xabirizar9/Micromaus-Challenge-TUM/MM_report.docx

Deadline: Montag 18.04

ToDo: Email an Lenz (X)

1. Introduction, Objectives N(2)
2. Conceptional Design (eagle) N(1)
3. Hardware
  a. Current supply A (1)
  b. Communication (USB API, WIFI) W(1)
  c. Sensing (IR & acceleration?) N (1)
  d. Motor (H-bridge, Encoder) X(1)
  e. ESP32 A(0.5)
4. Software
  a. RTOS (timer, task scheduling etc., class diagram) N (1)
  b. Filtering A(2)
  c. Maze solving (pathfinding) W(1)
  d. Kinematics (Curves, motion profile) X(2)
  e. Controlling (Lane & Motor)
    i. Motor controller N(1)
    ii. lane control X(1)
    iii. auto tuner X(1)
  f. Dashboard + communication W(2)
5. Results and Discussion
  a. results (1)
  b. further improvements (1)

Pages: W:5, A:3.5, X:5, N:6 total: 19.5
