xabirizar9/Micromaus-Challenge-TUM/docs/Micromaus-WS21_22.drawio-2.png

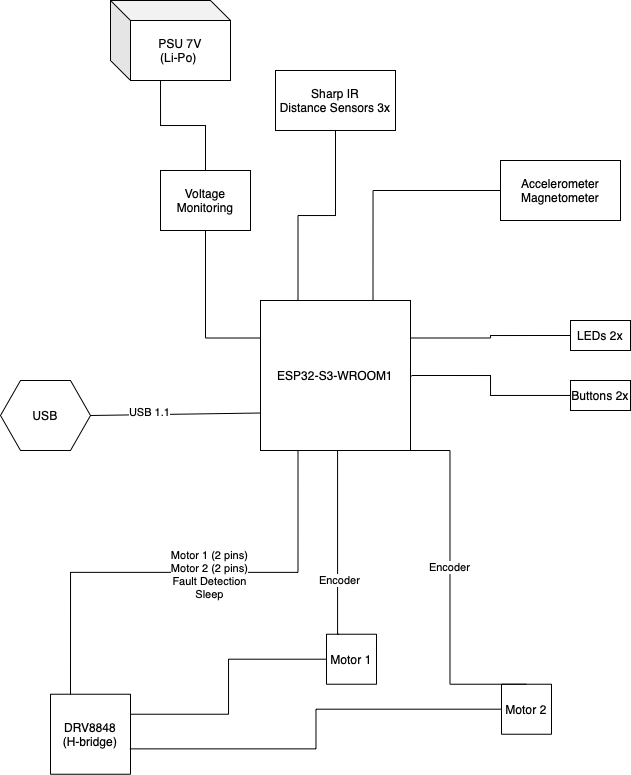
docs/Micromaus-WS21_22.drawio-2.png
