xabirizar9/Micromaus-Challenge-TUM/pcb/maus-qr.bmp

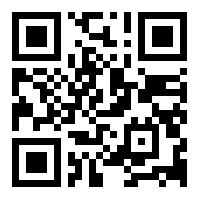
pcb/maus-qr.bmp
