xabirizar9/Micromaus-Challenge-TUM/pcb/maus.png

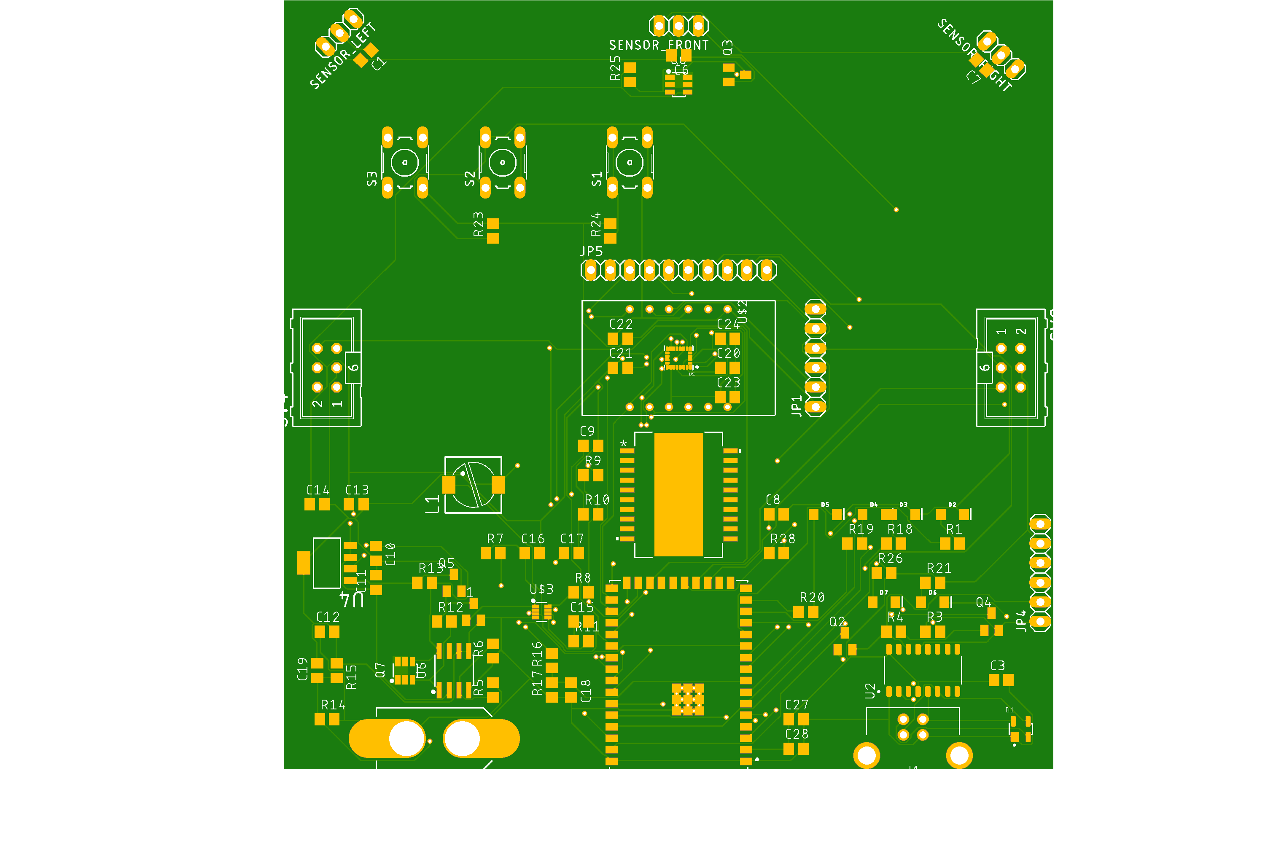
pcb/maus.png
