xabirizar9/Micromaus-Challenge-TUM/docs/parts.md

# Unsorted component list

- ESP32? (needs to be clarified with Lenz)
