xabirizar9/Micromaus-Challenge-TUM/bestellliste_merge.xlsx

Sheet: Pollin
Micromouse WS 2021/22
Lieferant: Pollin
https://www.pollin.de
Bestellnr | Beschreibung | Menge | Einzelpreis (ohne Mwst) | Gesamtpreis | Kommentar | Team WAXN | Team minimouse | Mendoza et al.
272136 | EXTRON Modellbau-Akkupack X2, LiPo, 7,4 V-/1300 mAh, 25C | 2 | 13.5 | 27 |  | 2
 |  |  | Gesamtsumme: | 27

Sheet: RS-online
Micromouse WS 2021/22
Lieferant: RS
https://de.rs-online.com/
Name | Bestellnummer | Beschreibung | Menge | Einzelpreis (ohne Mwst) | Gesamtpreis | Kommentar | Team WAXN | Team minimouse | Mendoza et al.
Motor | 921-1307 | Faulhaber 2619 SR Bürsten-Getriebemotor DC-Getriebemotor bis 10 Ncm 1257:1, 6 V / 1,11 W, Wellen-Ø 3mm, 26 (Dia.)mm | 6 | 203.47 | 1220.82 | nicht lieferbar, aber Alex hat wohl noch einige | 2 | 2 | 2
Chip | 666-8491 | Digitaler Signalprozessor 16bit dsPIC33FJ64MC804-I/PT, 40MHz 16 KB 64 KB Flash, TQFP 44-Pin 9-Kanal x 10 Bit, 9-Kanal x | 3 | 5.62 | 16.86 | nur einer lieferbar! Danach ab 25.04.22 Alex hat evtl. noch welche |  | 1 | 2
Crystal Oscillator | 693-8819 | HC49-4H Crystal 16 MHz | 2 | 0.65 | 1.3 |  |  |  | 2
Inductor | 308-8570 | 0805 inductor | 2 | 0.7 | 1.4 |  |  |  | 2
Pinheader 1 row | 251-8632 | For programmer & sensors | 3 | 1.502 | 4.506 |  |  |  | 3
Pinheader 2x3 | 832-3496 | Motor connectors | 3 | 0.45 | 1.35 |  |  |  | 3
Socket | 488-1724 | Socket for UART connections | 2 | 4.05 | 8.1 |  |  |  | 2
H-Bridge | 699-6752 | BD6222HFP-TR H-Bridge IC | 3 | 4.94 | 14.82 |  |  |  | 3
Voltage Regulator 3V3 | 534-3021 | Texas Instrumens LM3940IT-3.3/ | 2 | 2.62 | 5.24 |  |  |  | 2
 |  |  |  | Gesamtsumme: | 1274.396

Sheet: Mouser
Micromouse WS 2021/22
Lieferant: Mouser
https://www.mouser.de/
Mouser-Nr | Beschreibung | Menge | Einzelpreis (ohne Mwst) | Gesamtpreis | Kommentar | WAXN | minimouse | Mendoza et al.
375-BTM-01 | Bluetooth Development Tools – 802.15.1 HC-06 Bluetooth Module | 1 | 20.17 | 20.17 |  |  | 1
749-SM0805HCL | LED low current, red, surface mount | 4 | 0.49 | 1.96 |  |  | 4
593-LTH5MM12VFR4400 | LED 5MM | 2 | 0.971 | 1.942 |  |  | 2
511-L293B | H-Brücke L293B | 2 | 4.77 | 9.54 |  |  | 2
549-CY16BPS | HC49/S 16MHz Crystal | 2 | 0.578 | 1.156 | Bestand, nicht lieferbar |  | 2
424-6-PIN-HEADER | Male Pin Headers 1 x 6 pins | 6 | 1.3 | 7.8 |  |  | 6
595-UA78M33CKCS | Voltage Regulator TO-220 5V | 2 | 3.17 | 6.34 | Bestand, nicht lieferbar |  | 2
926-LM1085IT33NOPB | Voltage Regulator TO-220 3.3 V (LDO) | 2 | 0.893 | 1.786 | bestand |  | 2
71-RCG080547K0JNEA | 47 kOhm, 0805, E24 +/-5% | 2 | 0.096 | 0.192 |  |  | 2
71-CRCW0805J-22K | 22 kOhm, 0805, E24 | 10 | 0.131 | 1.31 |  | 5 | 5
71-CRCW0805J-33K | 33 kOhm, 0805, E24: | 2 | 0.131 | 0.262 |  | 2
71-RCG080510K0JNEA | 10 kOhm, 0805, E24 +/-5% | 17 | 0.096 | 1.632 |  | 10 | 2 | 5
71-RCG08051K00JNEA | 1 kOhm, 0805, E24 +/-5% | 16 | 0.096 | 1.536 |  | 9 | 4 | 3
71-RCG0805100KJNEA | 100 kOhm, 0805, E24: | 2 | 0.096 | 0.192 |  | 2
667-ERJ-P06J681V | 680 ohm 0805 | 6 | 0.105 |  |  |  |  | 6
852-GP2Y0A51SK0F | Sharp distance sensor | 10 | 8.35 | 83.5 | Bestand (?),nicht lieferbar | 3 | 4 | 3
241-SS0520_R1_00001 | diode, surface mount, 20V, 0.5A, SOD-123 | 15 | 0.245 | 3.675 |  |  | 15
80-C0805X104K3RAUTO | capacitor ceramic, 100nF, 0805 | 33 | 0.376 | 12.408 |  | 6 | 15 | 12
80-C0805C224K1RECAUT | capacitor ceramic, 220nF, 0805 | 3 | 0.245 |  |  |  |  | 3
80-C0805C474K3RECLR | capacitor ceramic, 470nF, 0805 | 3 | 0.263 |  |  |  |  | 3
80-C0805C150G8HACTU | capacitor ceramic, 15pF, 0805 | 4 | 0.175 | 0.7 |  |  | 4
80-C0805C200K5HAUTO | capacitor ceramic, 20pF, 0805 | 4 | 0.14 |  |  |  |  | 4
80-C0805C102F8HAUTO | capacitor ceramic, 1000 pF, 0805: | 3 | 0.289 | 0.867 |  | 3
80-C0805C334J3REAULR | capacitor ceramic, 0.33uF, 0805 | 2 | 0.298 | 0.596 |  |  | 2
80-C0805C226K7PACTU | capacitor ceramic, 22 uF, 0805: | 6 | 0.56 | 3.36 |  | 6
810-C2012X5R0J336M | capacitor ceramic, 33 uF, 0805: | 5 | 0.735 | 3.675 |  | 2 |  | 3
963-LMR212BD7106KG-T | capacitor ceramic, 10uF, 0805 | 11 | 0.368 | 4.048 |  | 6 | 2 | 3
80-T529P106M06AAE200 | capacitor tantalum, 10uF, 0805 | 2 | 1.29 | 2.58 |  |  | 2
581-F381A475MSA | capacitor tantalum, 4.7uF, 0805 | 2 | 0.901 | 1.802 |  |  | 2
710-744770147 | ind 47h | 2 | 2.04 | 4.08 |  | 2
621-AP1509-50SG-13 | AP1509-50SG-13 | 2 | 1.24 | 2.48 |  | 2
356-ESP32S2WRM3200PH | ESP32-S2-WROOM(M22S2H3200PH3Q0) | 2 | 1.85 | 3.7 |  | 2
485-4554 | ICM-20948 devboard | 1 | 13.08 | 13.08 | nicht lieferbar, Kann fehlen | 1
511-L298P | L298P | 2 | 7.67 | 15.34 |  | 2
595-LM358DR | LM358DR | 2 | 0.341 | 0.682 |  | 2
926-LP3965EMP-33 | LP3965EMP-3.3 | 2 | 4.2 | 8.4 |  | 2
771-PMN40XPEAX | PMN40XPEAX | 4 | 0.368 | 1.472 |  | 4
755-RBR2VWM40ATFTR | RBR2VWM40ATFTR | 15 | 0.49 | 7.35 |  | 15
576-SP0503BAHTG | SP0503BAHTG | 2 | 0.805 | 1.61 |  | 2
530-SS-52300-001 | SS-52300-001 | 2 | 0.936 | 1.872 |  | 2
426-FIT0587 | XT60 conn | 2 | 1.31 | 2.62 |  | 2
653-B3F-1002 | tactile switch | 10 | 0.324 | 3.24 |  | 3 | 4 | 3
604-APTD3216LSURCK | led rd 3mA 1206 | 6 | 0.42 | 2.52 |  | 6
755-SML-211UTT86 | Red LED | 6 | 0.34 | 2.04 |  |  |  | 6
625-RGL41A-E3 | Diodes | 3 | 0.43 | 1.29 |  |  |  | 3
859-LTL2R3KYD-EM | Support led | 2 | 0.09 | 0.18 |  |  |  | 2
926-LM7805CT/NOPB | Voltage Regulator 5V | 2 | 1.72 | 3.44 |  |  |  | 2
 |  | 0 |  | 0
 |  |  | Gesamtsumme: | 248.425

Sheet: Pololu
Micromouse WS 2021/22
Lieferant: Pololu
https://www.pololu.com/
Pololu-Nr | Beschreibung | Menge | Einzelpreis USD | Gesamtpreis USD | Kommentar | Team WAXN | Team minimouse | Mendoza et al.
1420 | Pololu Wheel 60×8mm Pair - Black | 3 | 4.25 | 12.75 | Bestand (?) | 1 | 1 | 1
 |  |  | Gesamtsumme: | 12.75
