xabirizar9/Micromaus-Challenge-TUM/docs/BestellungRS_2018_05_08-2.xls

Lieferant: RS
https://de.rs-online.com/
Bestellnummer | Beschreibung | Menge | Einzelpreis | Gesamtpreis
146-0786 | Sharp Reflektierender Sensor, Oberflächenmontage, 15cm, 27 x 13.2 x 12mm | 5 | 6.63 | 33.15
666-6568 | Sharp Reflektierender Sensor, 300mm | 2 | 7.19 | 14.38
666-8444 | DSP 16bit dsPIC33FJ32MC304-I/PT, 40MHz 4 KB 32 KB Flash, TQFP 44-Pin 9-Kanal x 10 Bit, 9-Kanal x 12 Bit ADC, 1 2 | 1 | 4.29 | 4.29
636-384 | IC-Motortreiber L298N, 4A MULTIWATT V 15-Pin 4,8 → 46 V | 3 | 4.63
536-1546 | LDO-Regler LM3940IMP-3.3/NOPB, fest 1A 3,3 Vout 1 SOT-223, 3+Tab-Pin, 4,5 → 7,5 Vin | 3 | 1.37 | 4.11
795-7124 | Operationsverstärker TSV632IDT Low Power, 1,5 → 5,5 V 880kHz SOIC, 8-Pin | 10 | 0.677 | 6.77
549-356 | DSP 16bit DSPIC33FJ64MC802-I/SP, 40MIPS 16 KB 64 KB Flash, SPDIP 28-Pin 6 x 10/12 Bit ADC, 1 0 1 0 6 2 0USB | 2 | 5 | 10
 |  |  |  | 0
 |  |  | Gesamtsumme: | 72.7
 |  |  |  | 0
 |  |  |  | 0
 |  |  |  | 0
 |  |  |  | 0
 |  |  |  | 0
 |  |  |  | 0
 |  |  |  | 0
 |  |  |  | 0
 |  |  |  | 0
 |  |  |  | 0
 |  |  |  | 0
 |  |  |  | 0
 |  |  |  | 0
