xabirizar9/Micromaus-Challenge-TUM/protokoll/schematic.pdf

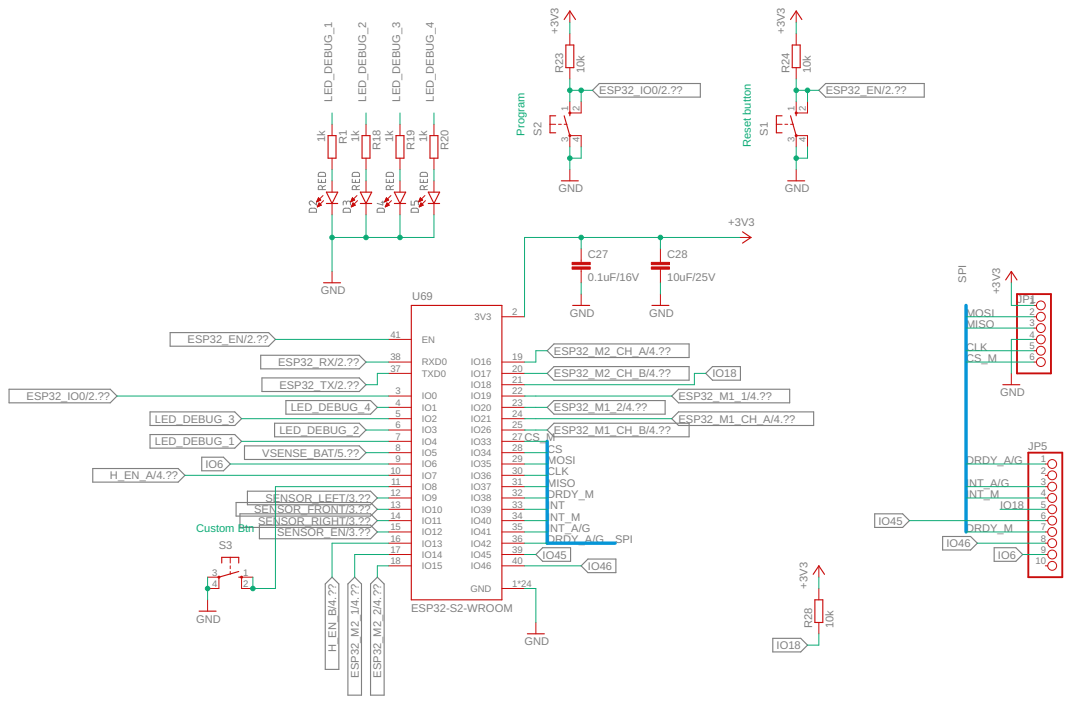
[picture p4: page 1]

LED_DEBUG_2 | ESP32_M1_CH_B/4.??

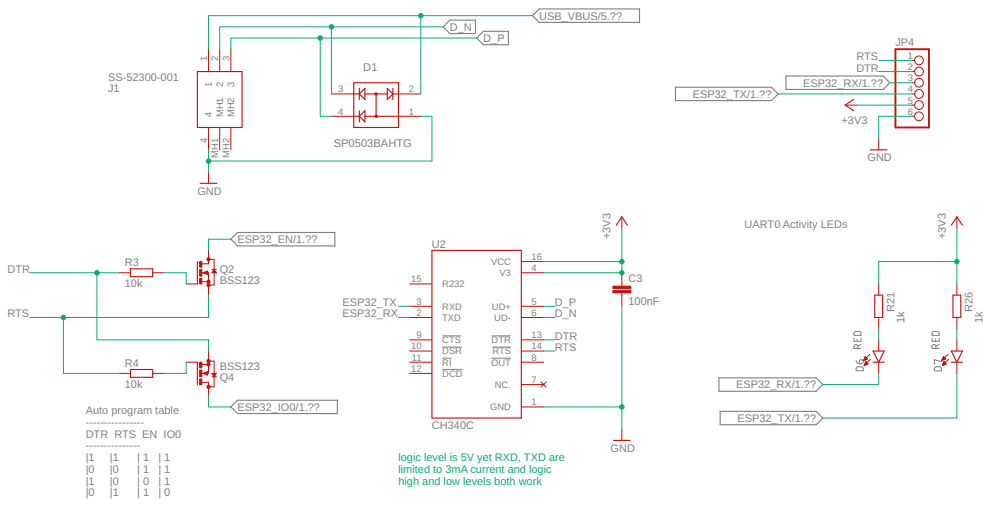
[picture p5: page 2]

logic level is 5V yet RXD, TXD are
limited to 3mA current and logic high and low levels both work

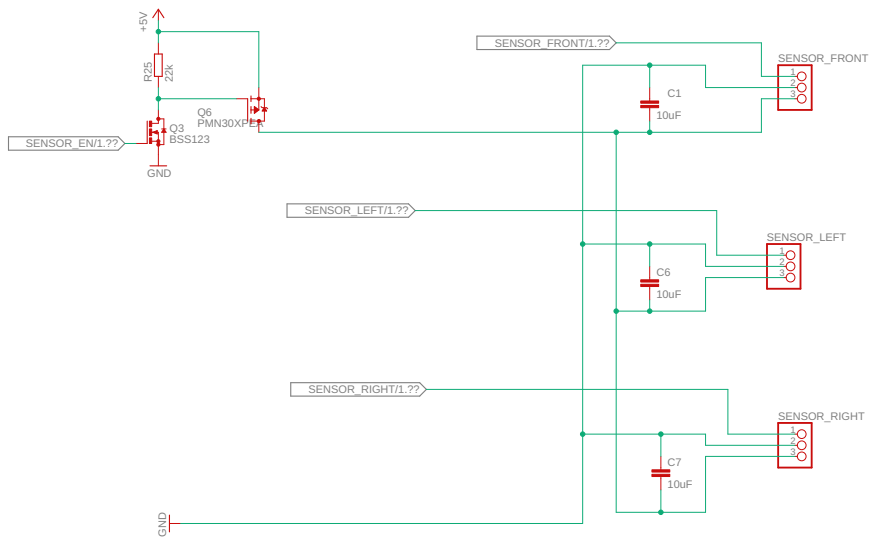
[picture p6: page 3]

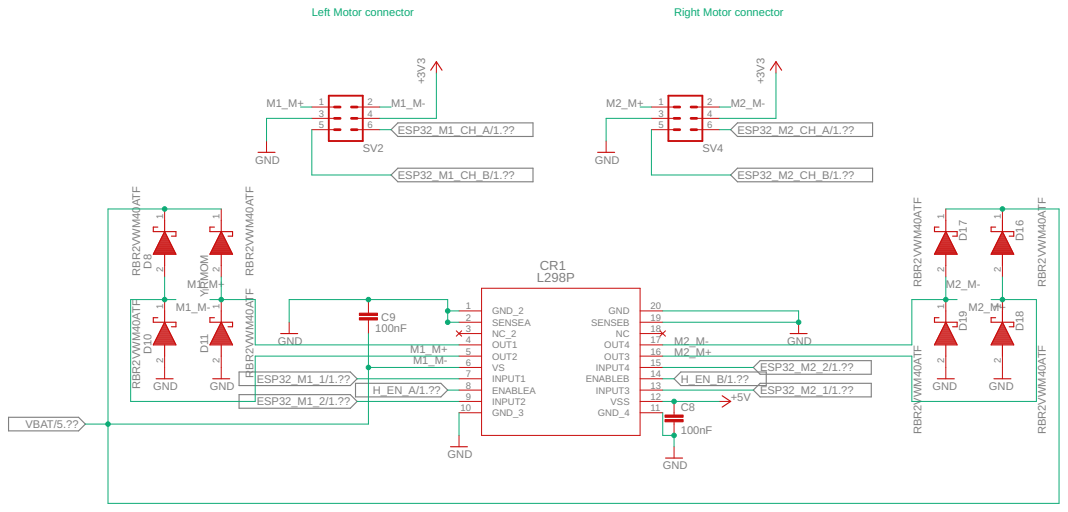
[picture p7: page 4]

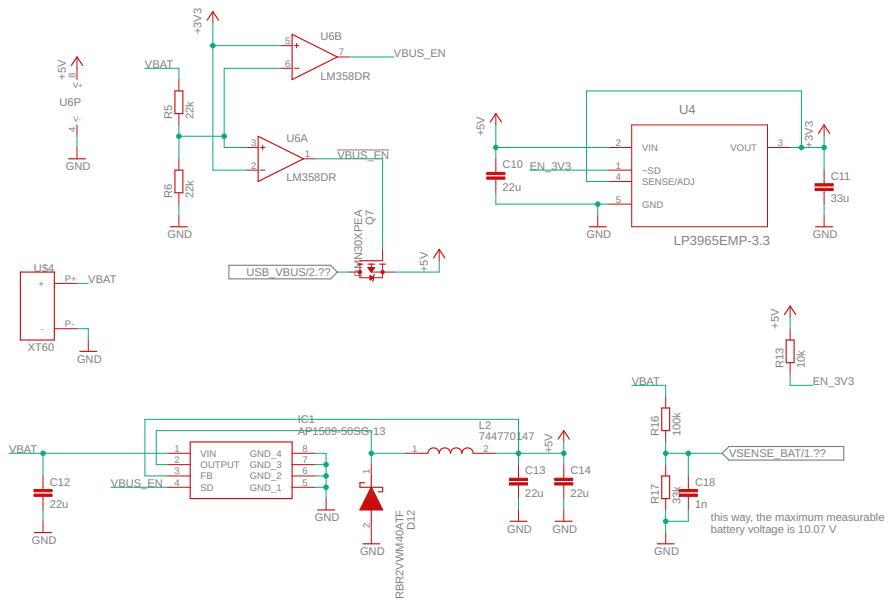
[picture p8: page 5]

this way, the maximum measurable
battery voltage is 10.07 V

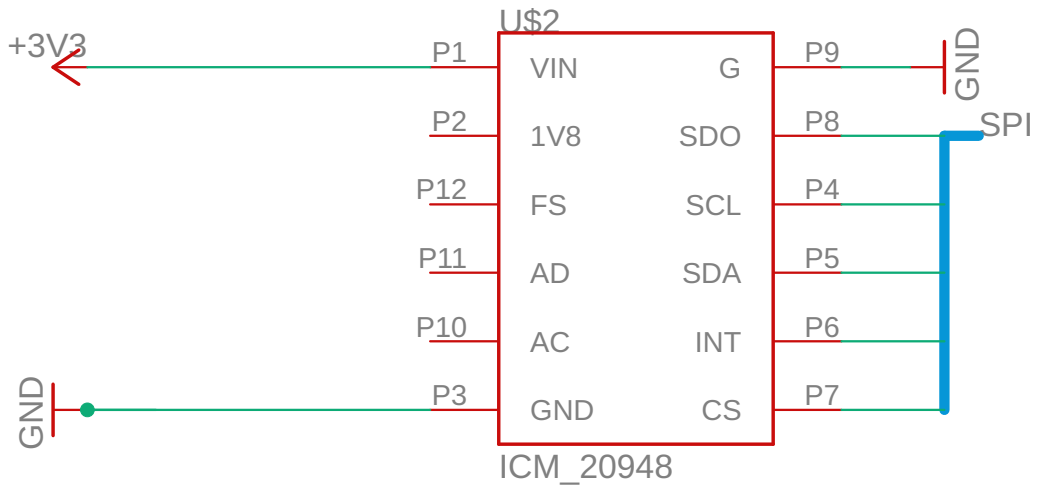
[picture p9: page 6]
