xabirizar9/Micromaus-Challenge-TUM/pcb/maus.brd

## EAGLE design pcb/maus.brd (2022-02-13)

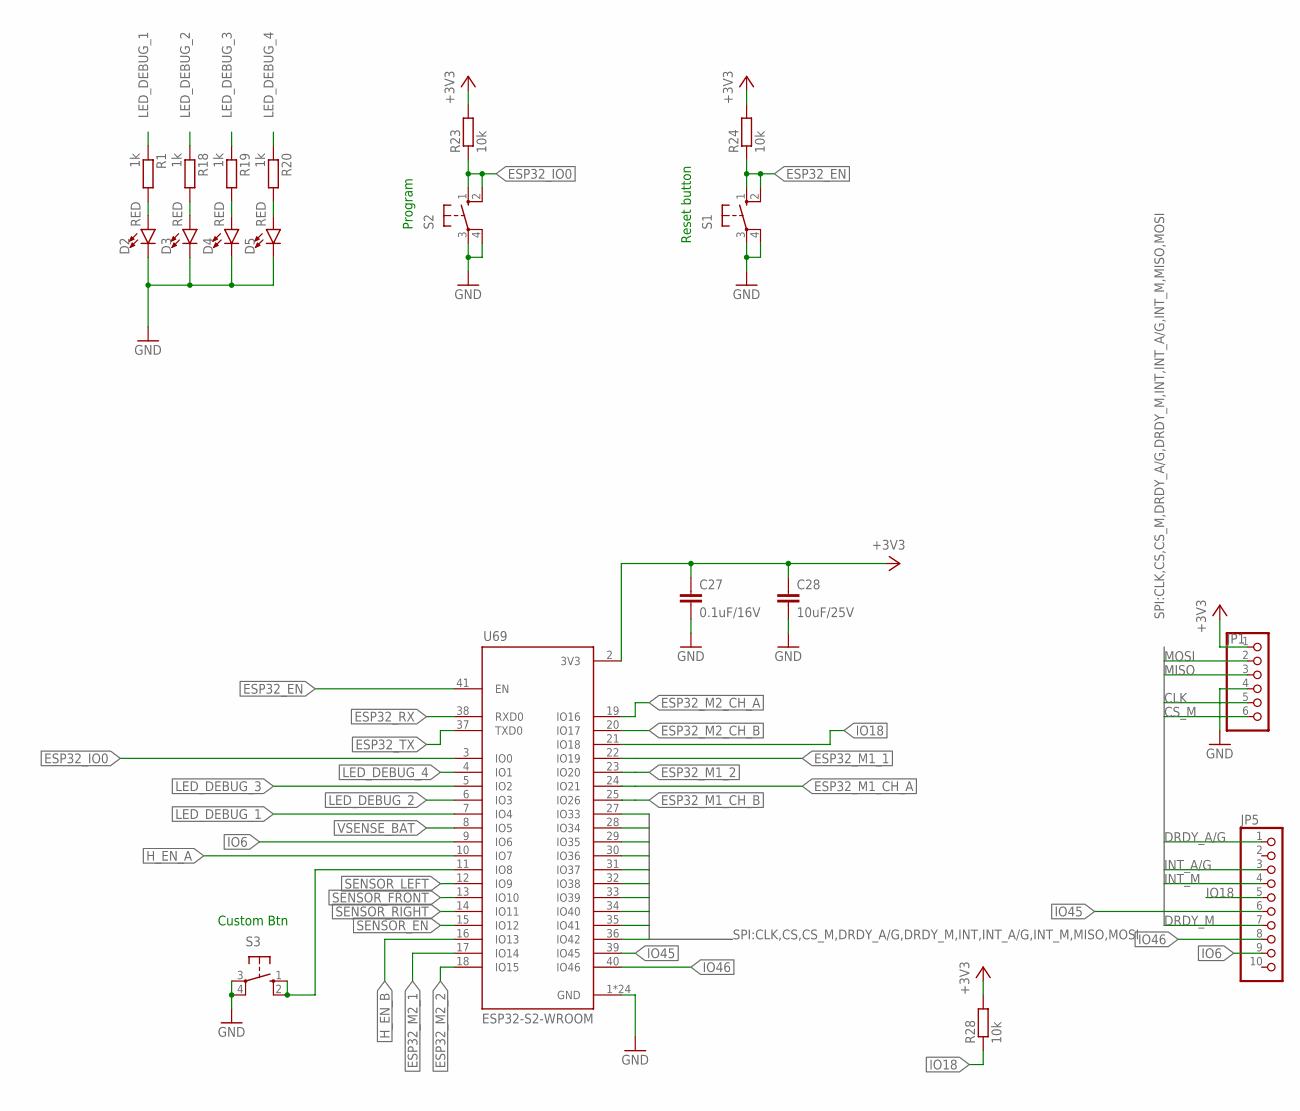
[picture p10: schematic maus.sch, sheet 1]

Parts:
C27: 0.1uF/16V; C0805
C28: 10uF/25V; C0805
D2, D3, D4, D5: RED; LED-1206
JP1: PINHD-1X6; 1X06
JP5: PINHD-1X10; 1X10
R1, R18, R19, R20: 1k; R0805
R23, R24, R28: 10k; R0805
S1, S2, S3: 10-XX; B3F-10XX
U69: ESP32-S2-WROOM; XCVR_ESP32-S2-WROOM

Connections:
+3V3: C27.1, C28.1, JP1.1, R23.2, R24.2, R28.2, U69.2 (3V3); also elsewhere on the board
CLK: JP1.5, U69.30 (IO36); also elsewhere on the board
CS: U69.28 (IO34); also elsewhere on the board
CS_M: JP1.6, U69.27 (IO33)
DRDY_A/G: JP5.1, U69.36 (IO42)
DRDY_M: JP5.7, U69.32 (IO38)
ESP32_EN: R24.1, S1.1 (S), S1.2 (S1), U69.41 (EN); also elsewhere on the board
ESP32_IO0: R23.1, S2.1 (S), S2.2 (S1), U69.3 (IO0); also elsewhere on the board
ESP32_M1_1: U69.22 (IO19); also elsewhere on the board
ESP32_M1_2: U69.23 (IO20); also elsewhere on the board
ESP32_M1_CH_A: U69.24 (IO21); also elsewhere on the board
ESP32_M1_CH_B: U69.25 (IO26); also elsewhere on the board
ESP32_M2_1: U69.17 (IO14); also elsewhere on the board
ESP32_M2_2: U69.18 (IO15); also elsewhere on the board
ESP32_M2_CH_A: U69.19 (IO16); also elsewhere on the board
ESP32_M2_CH_B: U69.20 (IO17); also elsewhere on the board
ESP32_RX: U69.38 (RXD0); also elsewhere on the board
ESP32_TX: U69.37 (TXD0); also elsewhere on the board
GND: C27.2, C28.2, D2.C, D3.C, D4.C, D5.C, JP1.4, S1.3, S1.4 (P1), S2.3, S2.4 (P1), S3.3, S3.4 (P1), U69.1 (GND), U69.26 (GND), U69.42 (GND), U69.43.1 (GND), U69.43.2 (GND), U69.43.3 (GND), U69.43.4 (GND), U69.43.5 (GND), U69.43.6 (GND), U69.43.7 (GND), U69.43.8 (GND), U69.43.9 (GND), U69.43.10 (GND), U69.43.11 (GND), U69.43.12 (GND), U69.43.13 (GND), U69.43.14 (GND), U69.43.15 (GND), U69.43.16 (GND), U69.43.17 (GND), U69.43.18 (GND), U69.43.19 (GND), U69.43.20 (GND), U69.43.21 (GND); also elsewhere on the board
H_EN_A: U69.10 (IO7); also elsewhere on the board
H_EN_B: U69.16 (IO13); also elsewhere on the board
INT: U69.33 (IO39); also elsewhere on the board
INT_A/G: JP5.3, U69.35 (IO41)
INT_M: JP5.4, U69.34 (IO40)
IO6: JP5.9, U69.9 (IO6)
IO18: JP5.5, R28.1, U69.21 (IO18)
IO45: JP5.6, U69.39 (IO45)
IO46: JP5.8, U69.40 (IO46)
LED_DEBUG_1: R1.1, U69.7 (IO4)
LED_DEBUG_2: R18.1, U69.6 (IO3)
LED_DEBUG_3: R19.1, U69.5 (IO2)
LED_DEBUG_4: R20.1, U69.4 (IO1)
MISO: JP1.3, U69.31 (IO37); also elsewhere on the board
MOSI: JP1.2, U69.29 (IO35); also elsewhere on the board
unnamed: S3.1 (S), S3.2 (S1), U69.11 (IO8)
unnamed: D2.A, R1.2
unnamed: D3.A, R18.2
unnamed: D4.A, R19.2
unnamed: D5.A, R20.2
SENSOR_EN: U69.15 (IO12); also elsewhere on the board
SENSOR_FRONT: U69.13 (IO10); also elsewhere on the board
SENSOR_LEFT: U69.12 (IO9); also elsewhere on the board
SENSOR_RIGHT: U69.14 (IO11); also elsewhere on the board
VSENSE_BAT: U69.8 (IO5); also elsewhere on the board

Notes on the sheet:
Reset button
Program
Custom Btn

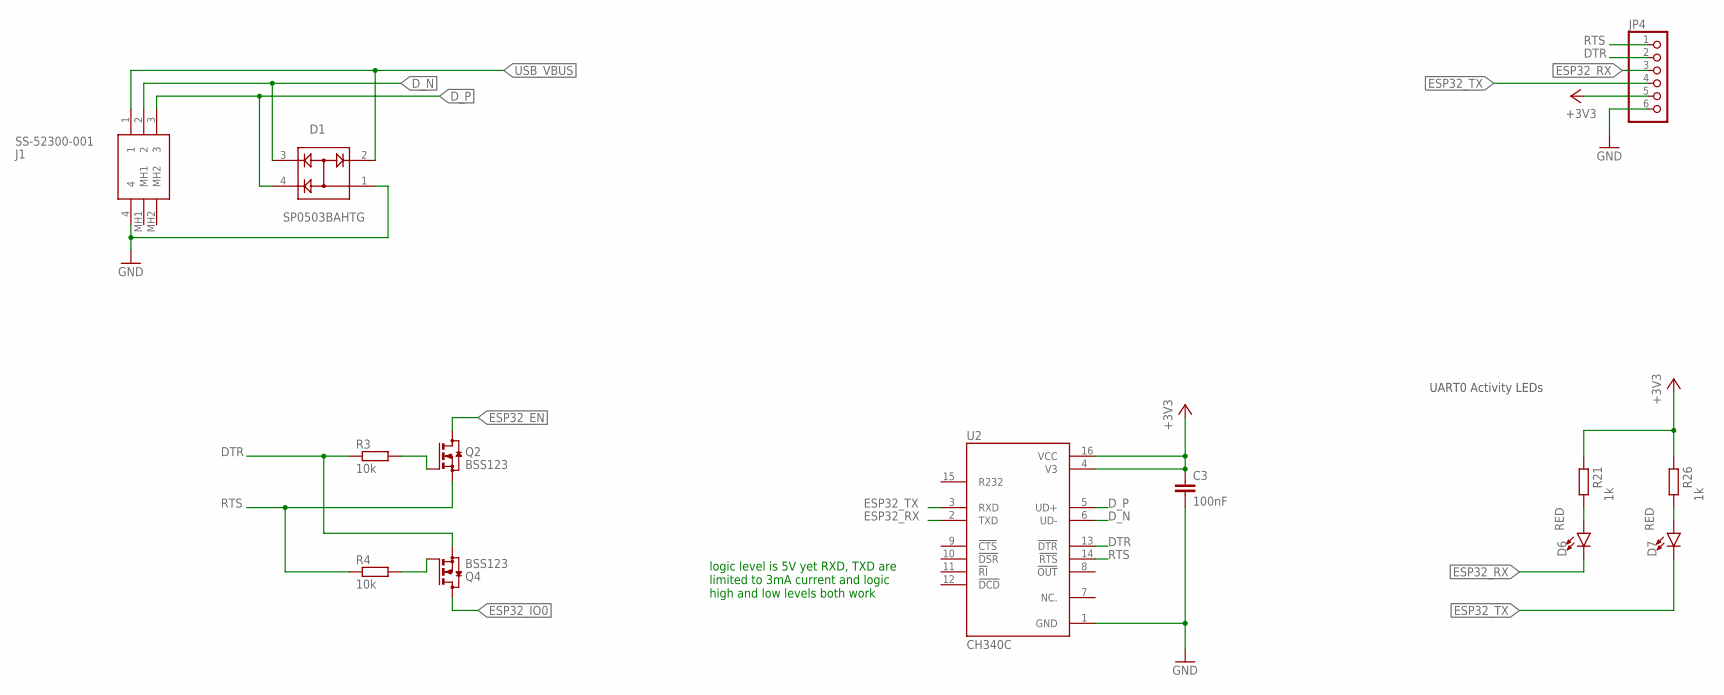
[picture p11: schematic maus.sch, sheet 2, UART/Prog]

Parts:
C3: 100nF; C0805
D1: SP0503BAHTG; SOT143
D6, D7: RED; LED-1206
J1: SS-52300-001; SS52300001
JP4: PINHD-1X6; 1X06
Q2, Q4: BSS123; SOT23
R3, R4: 10k; R0805
R21, R26: 1k; R0805
U2: CH340C; SOIC127P600X180-16N

Connections:
+3V3: C3.1, JP4.5, R21.2, R26.2, U2.4 (V3), U2.16 (VCC); also elsewhere on the board
DTR: JP4.2, Q4.2 (S), R3.1, U2.13 (!DTR)
D_N: D1.3, J1.2, U2.6 (UD-)
D_P: D1.4, J1.3, U2.5 (UD+)
ESP32_EN: Q2.3 (D); also elsewhere on the board
ESP32_IO0: Q4.3 (D); also elsewhere on the board
ESP32_RX: D6.C, JP4.3, U2.2 (TXD); also elsewhere on the board
ESP32_TX: D7.C, JP4.4, U2.3 (RXD); also elsewhere on the board
GND: C3.2, D1.1, J1.4, JP4.6, U2.1 (GND); also elsewhere on the board
unnamed: Q2.1 (G), R3.2
unnamed: Q4.1 (G), R4.2
unnamed: D6.A, R21.1
unnamed: D7.A, R26.1
RTS: JP4.1, Q2.2 (S), R4.1, U2.14 (!RTS)
USB_VBUS: D1.2, J1.1; also elsewhere on the board

Notes on the sheet:
UART0 Activity LEDs
logic level is 5V yet RXD, TXD are limited to 3mA current and logic high and low levels both work

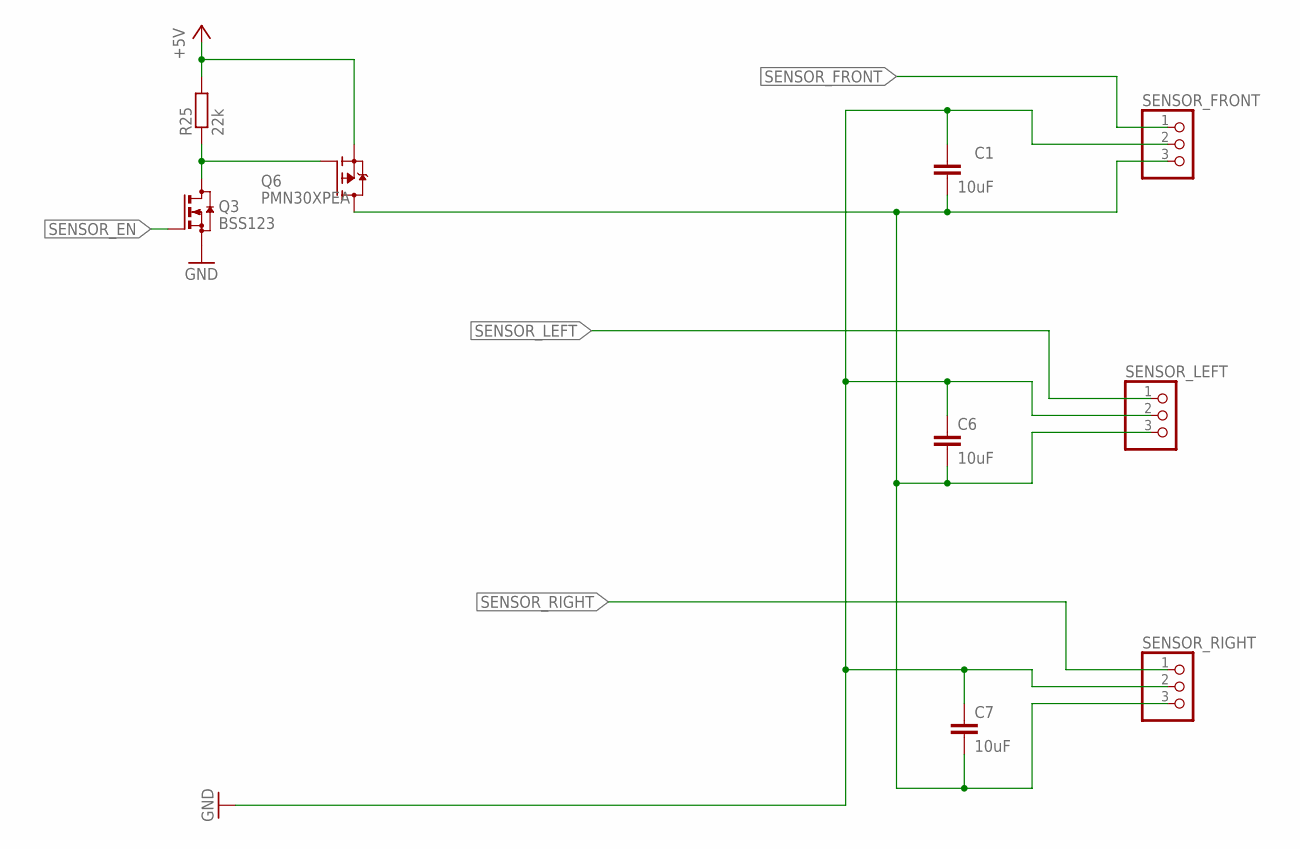
[picture p12: schematic maus.sch, sheet 3, IR]

Parts:
C1, C6, C7: 10uF; C0805
Q3: BSS123; SOT23
Q6: PMN30XPEA; SOT95P255X110-6N
R25: 22k; R0805
SENSOR_FRONT: PINHD-1X3; 1X03
SENSOR_LEFT: PINHD-1X3; 1X03
SENSOR_RIGHT: PINHD-1X3; 1X03

Connections:
+5V: Q6.4 (S), R25.2; also elsewhere on the board
GND: C1.1, C6.1, C7.1, Q3.2 (S), SENSOR_FRONT.2, SENSOR_LEFT.2, SENSOR_RIGHT.2; also elsewhere on the board
unnamed: Q3.3 (D), Q6.3 (G), R25.1
unnamed: C1.2, C6.2, C7.2, Q6.1 (D), Q6.2 (D), Q6.5 (D), Q6.6 (D), SENSOR_FRONT.3, SENSOR_LEFT.3, SENSOR_RIGHT.3
SENSOR_EN: Q3.1 (G); also elsewhere on the board
SENSOR_FRONT: SENSOR_FRONT.1; also elsewhere on the board
SENSOR_LEFT: SENSOR_LEFT.1; also elsewhere on the board
SENSOR_RIGHT: SENSOR_RIGHT.1; also elsewhere on the board

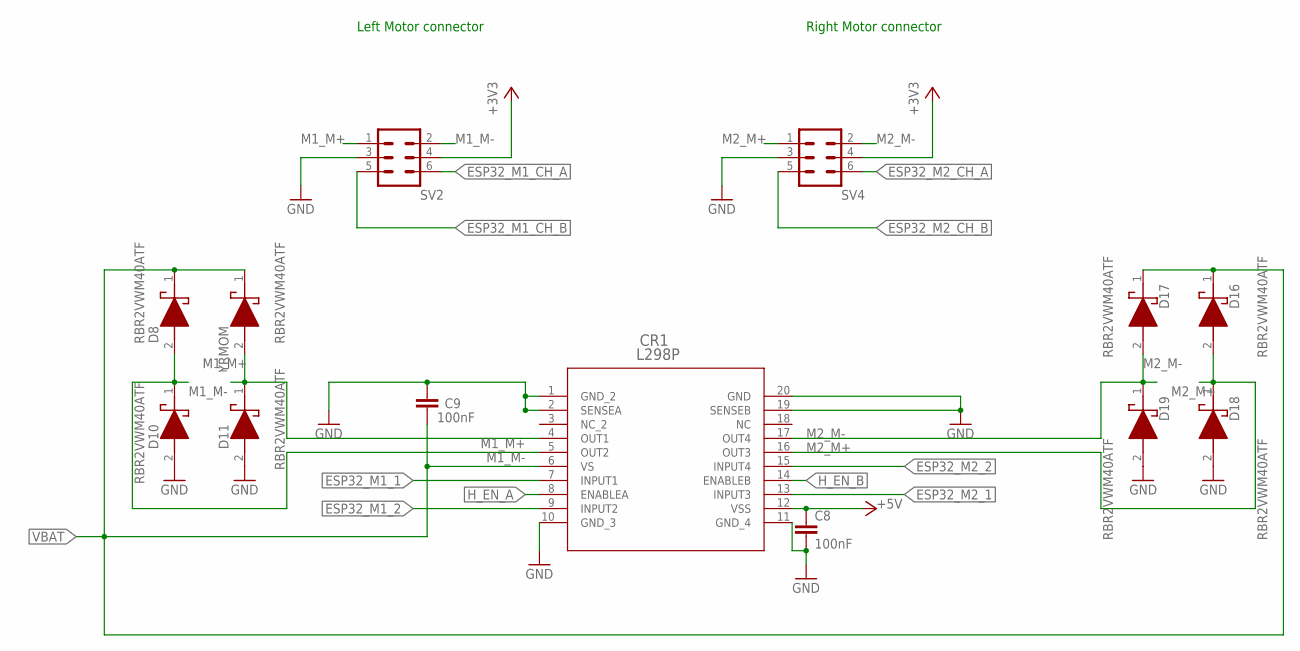
[picture p13: schematic maus.sch, sheet 4, H-bridge motor driver]

Parts:
C8, C9: 100nF; C0805
CR1: L298P; POWERSO-20_STM
D8, D10, D11, D16, D17, D18, D19: RBR2VWM40ATF; RB068VWM100
SV2, SV4: ML6
YRMOM: RBR2VWM40ATF; RB068VWM100

Connections:
+3V3: SV2.4, SV4.4; also elsewhere on the board
+5V: C8.1, CR1.12 (VSS); also elsewhere on the board
ESP32_M1_1: CR1.7 (INPUT1); also elsewhere on the board
ESP32_M1_2: CR1.9 (INPUT2); also elsewhere on the board
ESP32_M1_CH_A: SV2.6; also elsewhere on the board
ESP32_M1_CH_B: SV2.5; also elsewhere on the board
ESP32_M2_1: CR1.13 (INPUT3); also elsewhere on the board
ESP32_M2_2: CR1.15 (INPUT4); also elsewhere on the board
ESP32_M2_CH_A: SV4.6; also elsewhere on the board
ESP32_M2_CH_B: SV4.5; also elsewhere on the board
GND: C8.2, C9.2, CR1.1 (GND_2), CR1.2 (SENSEA), CR1.10 (GND_3), CR1.11 (GND_4), CR1.19 (SENSEB), CR1.20 (GND), D10.2 (A), D11.2 (A), D18.2 (A), D19.2 (A), SV2.3, SV4.3; also elsewhere on the board
H_EN_A: CR1.8 (ENABLEA); also elsewhere on the board
H_EN_B: CR1.14 (ENABLEB); also elsewhere on the board
M1_M+: CR1.4 (OUT1), D11.1 (K), SV2.1, YRMOM.2 (A)
M1_M-: CR1.5 (OUT2), D8.2 (A), D10.1 (K), SV2.2
M2_M+: CR1.16 (OUT3), D16.2 (A), D18.1 (K), SV4.1
M2_M-: CR1.17 (OUT4), D17.2 (A), D19.1 (K), SV4.2
VBAT: C9.1, CR1.6 (VS), D8.1 (K), D16.1 (K), D17.1 (K), YRMOM.1 (K); also elsewhere on the board

Notes on the sheet:
Left Motor connector
Right Motor connector

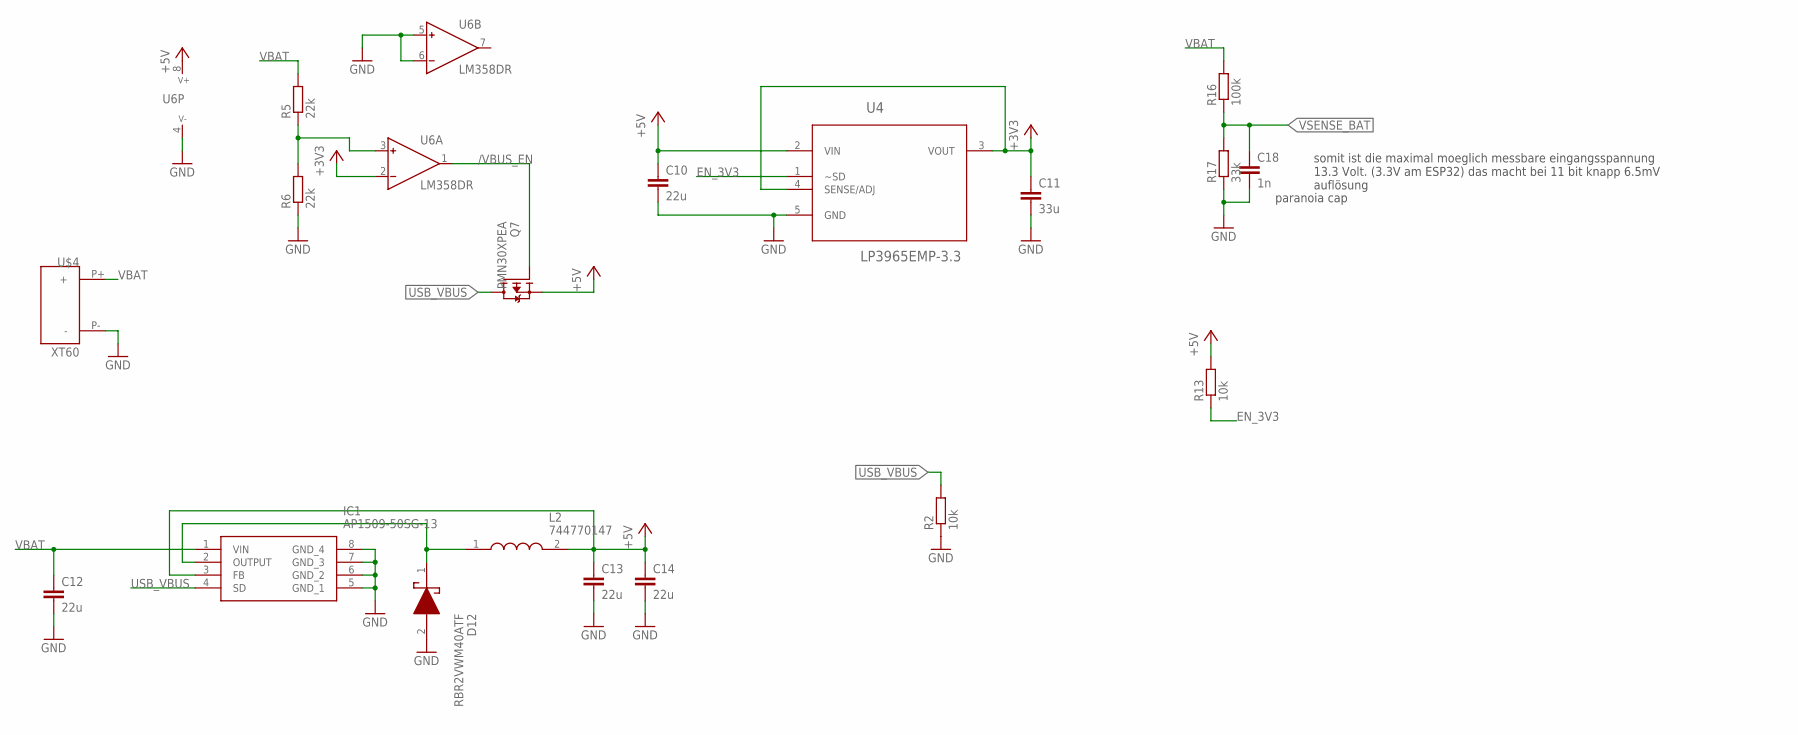
[picture p14: schematic maus.sch, sheet 5, power]

Parts:
C10, C12, C13, C14: 22u; C0805
C11: 33u; C0805
C18: 1n; C0805
D12: RBR2VWM40ATF; RB068VWM100
IC1: AP1509-50SG-13; SOIC127P600X175-8N
L2: 744770147; WE-PD_1260/1245/1280/121054
Q7: PMN30XPEA; SOT95P255X110-6N
R2, R13: 10k; R0805
R5, R6: 22k; R0805
R16: 100k; R0805
R17: 33k; R0805
U4: LP3965EMP-3.3; SOT150P696X180-5N
U6: LM358DR; SOIC127P610X175-8N
U$4: XT60; XT60-UPRIGHT

Connections:
+3V3: C11.1, U4.3 (VOUT), U4.4 (SENSE/ADJ), U6.2 (IN-); also elsewhere on the board
+5V: C10.1, C13.1, C14.1, IC1.3 (FB), L2.2, Q7.4 (S), R13.2, U4.2 (VIN), U6.8 (V+); also elsewhere on the board
/VBUS_EN: Q7.3 (G), U6.1 (OUT)
EN_3V3: R13.1, U4.1 (~SD)
GND: C10.2, C11.2, C12.2, C13.2, C14.2, C18.2, D12.2 (A), IC1.5 (GND_1), IC1.6 (GND_2), IC1.7 (GND_3), IC1.8 (GND_4), R2.1, R6.1, R17.1, U4.5 (GND), U6.4 (V-), U6.5 (IN+), U6.6 (IN-), U$4.P- (-); also elsewhere on the board
unnamed: D12.1 (K), IC1.2 (OUTPUT), L2.1
unnamed: R5.1, R6.2, U6.3 (IN+)
USB_VBUS: IC1.4 (SD), Q7.1 (D), Q7.2 (D), Q7.5 (D), Q7.6 (D), R2.2; also elsewhere on the board
VBAT: C12.1, IC1.1 (VIN), R5.2, R16.2, U$4.P+ (+); also elsewhere on the board
VSENSE_BAT: C18.1, R16.1, R17.2; also elsewhere on the board

Notes on the sheet:
somit ist die maximal moeglich messbare eingangsspannung 13.3 Volt. (3.3V am ESP32) das macht bei 11 bit knapp 6.5mV auflösung
paranoia cap

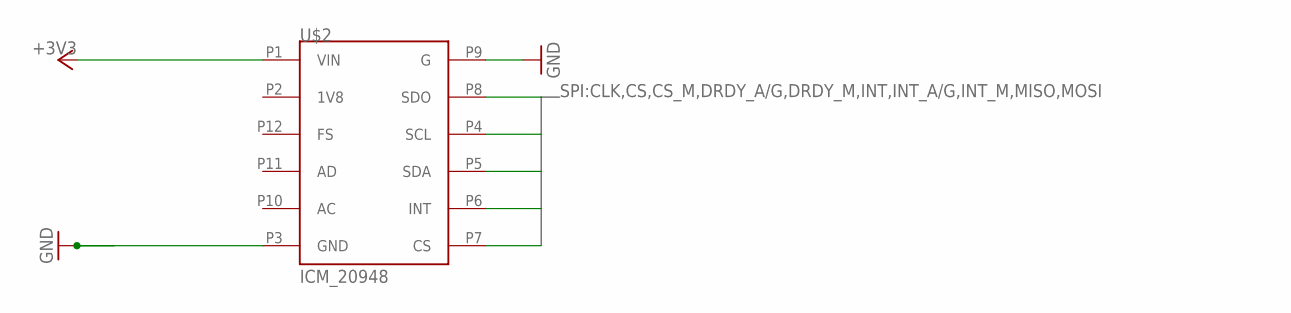
[picture p15: schematic maus.sch, sheet 6, navigation]

Parts:
U$2: ICM_20948; ICM_20948-F

Connections:
+3V3: U$2.P1 (VIN); also elsewhere on the board
CLK: U$2.P4 (SCL); also elsewhere on the board
CS: U$2.P7 (CS); also elsewhere on the board
GND: U$2.P3 (GND), U$2.P9 (G); also elsewhere on the board
INT: U$2.P6 (INT); also elsewhere on the board
MISO: U$2.P8 (SDO); also elsewhere on the board
MOSI: U$2.P5 (SDA); also elsewhere on the board

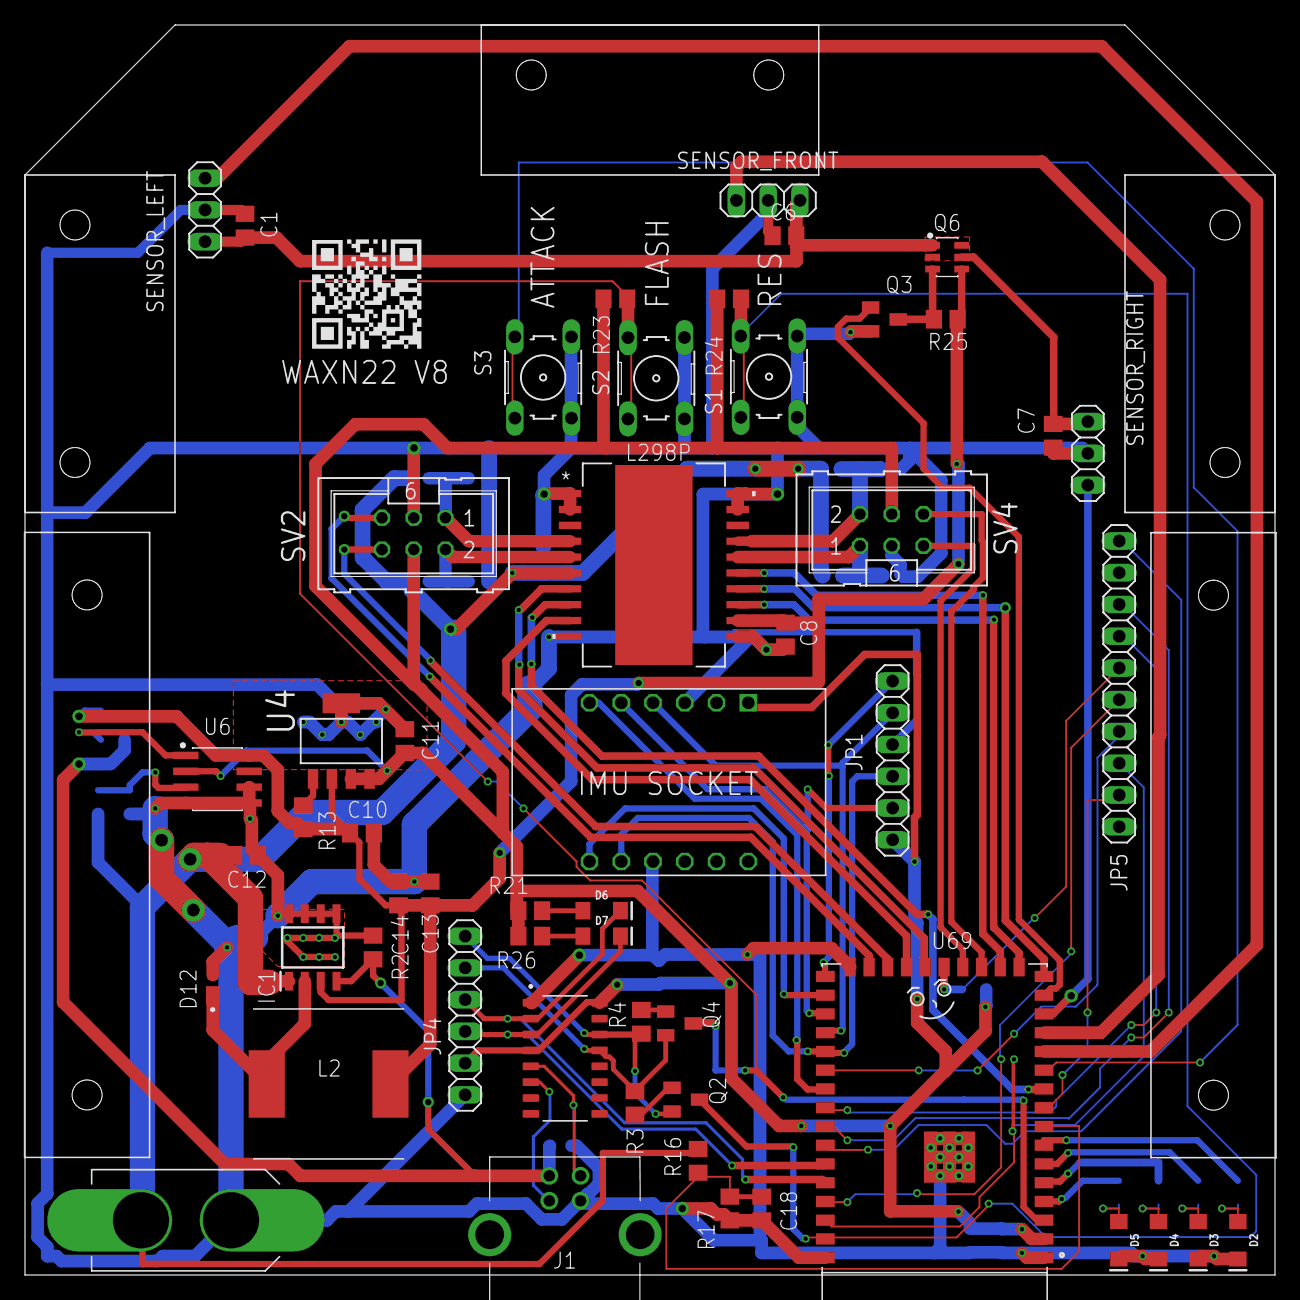
[picture p16: board maus.brd from above]

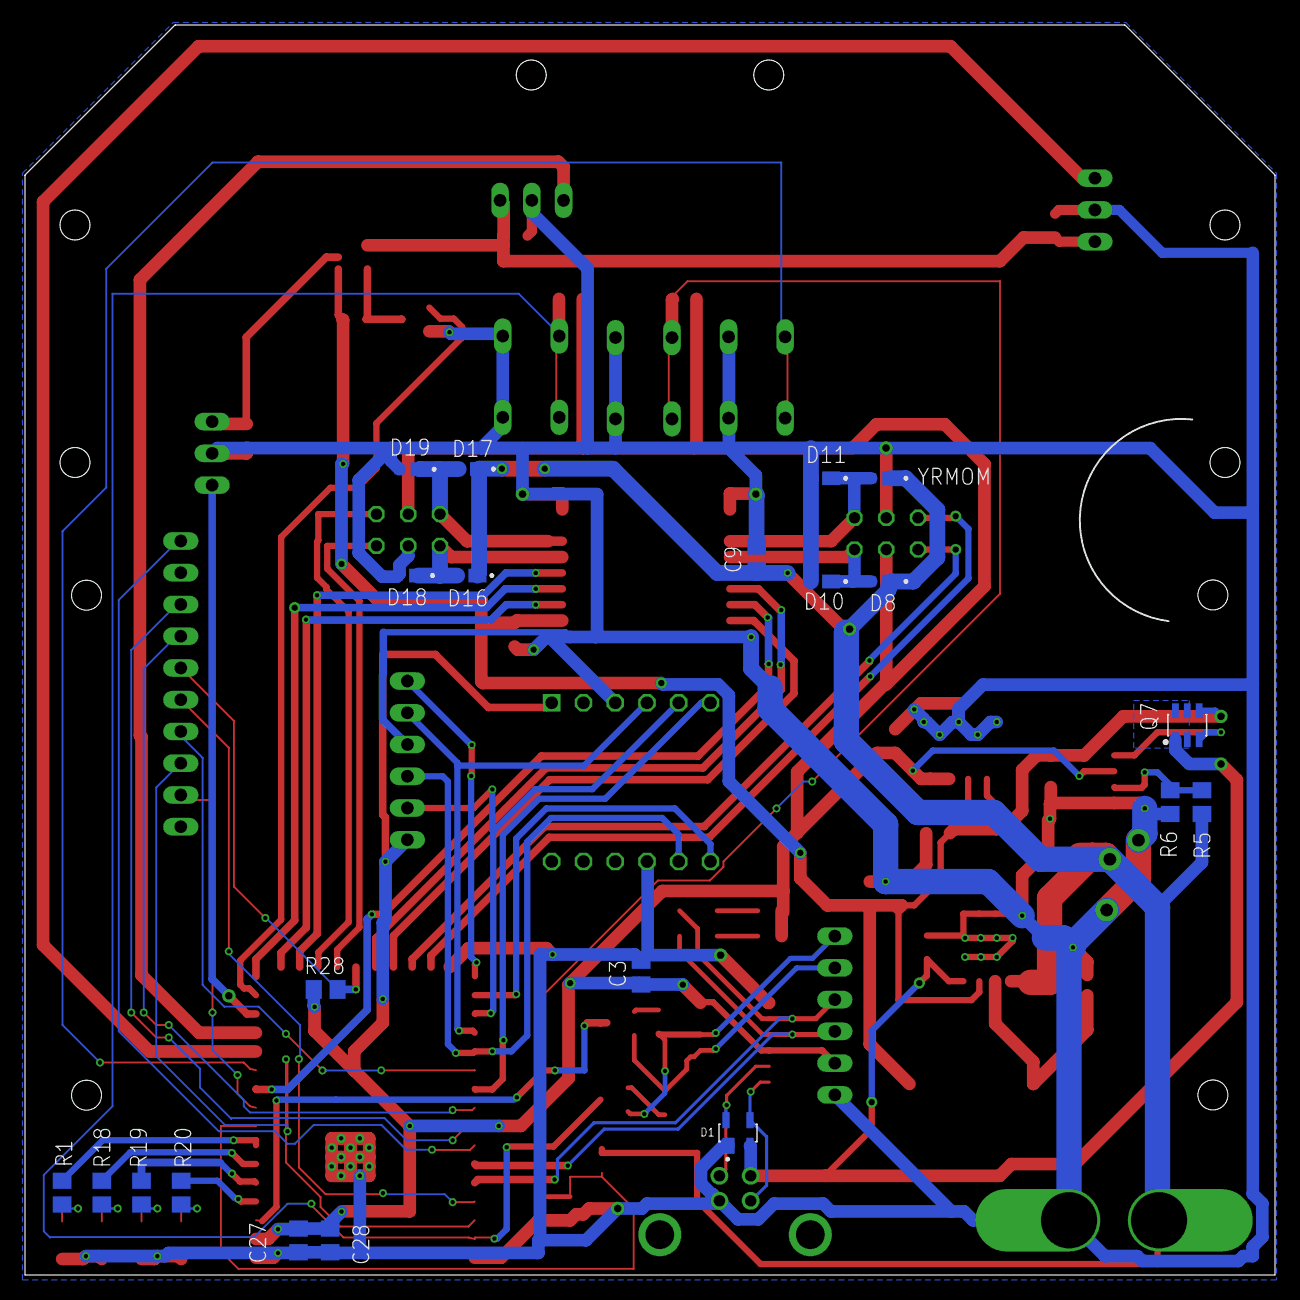
[picture p17: board maus.brd from below]

Board: 2 copper layers, 100.0 x 100.0 mm, 79 parts (21 on the bottom side), 65 nets.

Other parts of the board:
U$1, U$3: MOTOR_HALTERUNG
U$6, U$7, U$8: SENSOR_HALTERUNG
