xabirizar9/Micromaus-Challenge-TUM/src/periph/NetController.cpp

#include "periph/NetController.hpp"

#include <math.h>
#include <stdbool.h>
#include <stdint.h>
#include <stdio.h>
#include <string.h>

#include "esp_log.h"
#include "freertos/FreeRTOS.h"
#include "freertos/message_buffer.h"
#include "freertos/queue.h"
#include "message.pb.h"
#include "pb_decode.h"
#include "pb_encode.h"
#include "sys/time.h"
// TODO: add toggle
// #include "periph/BluetoothCore.hpp"
#include "config.h"
#include "periph/WifiCommunicator.hpp"

static const char *tag = "NET";

using namespace NetController;

void testTask(void *pvParameter) {
	uint8_t i = 0;

	NetController::Manager *manager = (NetController::Manager *)pvParameter;

	NavigationPacket packet = NavigationPacket_init_zero;
	packet.has_position = true;
	packet.has_sensors = true;
	packet.position = Position_init_zero;
	packet.sensors = SensorPacket_init_zero;

	while (true) {
		// TODO: replace with actual position data
		packet.position.x = sin((float)i / 10.0);
		packet.position.y = cos((float)i / 10.0);
		packet.sensors.left = ((float)rand() / (float)(RAND_MAX)) * 2;
		packet.sensors.front = ((float)rand() / (float)(RAND_MAX)) * 2;
		packet.sensors.right = ((float)rand() / (float)(RAND_MAX)) * 2;

		if (manager->initCompleted) {
			manager->writePacket<NavigationPacket, MausOutgoingMessage_nav_tag>(packet);
			i++;
		}
		vTaskDelay(pdMS_TO_TICKS(200));
	}
}

void receiverTask(void *pvParameter) {
	uint16_t msgLen = 0;
	NetController::Manager *manager = (NetController::Manager *)pvParameter;
	uint8_t *buffer = manager->decodeBuffer;
	MausIncomingMessage msg = MausIncomingMessage_init_default;
	MessageBufferHandle_t msgBuffer = manager->comInterface.getCmdReceiverMsgBuffer();
	ESP_LOGI(tag, "receiverTask started");

	while (true) {
		if (msgBuffer == NULL) {
			ESP_LOGD(tag, "not initialized");
			vTaskDelay(pdMS_TO_TICKS(20));
			continue;
		}
		msgLen = xMessageBufferReceive(msgBuffer, buffer, sizeof(buffer), 0);
		if (msgLen == 0) {
			// ESP_LOGI(tag, "queue empty");
			vTaskDelay(pdMS_TO_TICKS(20));
			continue;
		}
		ESP_LOGI(tag, "persed incoming msg, bufLen=%d, msgLen=%d", sizeof(buffer), msgLen);

		pb_istream_t stream = pb_istream_from_buffer(buffer, msgLen);
		if (!pb_decode(&stream, MausIncomingMessage_fields, &msg)) {
			ESP_LOGE(tag, "failed to decode: %s", PB_GET_ERROR(&stream));
			continue;
		}

		switch (msg.which_payload) {
			case MausIncomingMessage_init_tag:
				ESP_LOGI(tag, "connected to connector v.%d", msg.payload.init.version);
				// TODO: improve memory management
				manager->writePacket<AckPacket, MausOutgoingMessage_ack_tag>(AckPacket_init_zero);
				manager->initCompleted = true;

				// TODO: move this somewhere else just here for testing
				xTaskCreate(&testTask, "testTask", 2048, manager, 5, NULL);

				break;
		}
	}
}
bool NetController::Manager::writeCmd(MausOutgoingMessage *msg) {
	MessageBufferHandle_t buffer = this->comInterface.getCmdSenderMsgBuffer();
	if (buffer == NULL) {
		ESP_LOGI(tag, "not initialized");
		return false;
	};

	// encode message in pb format
	pb_ostream_t stream = pb_ostream_from_buffer(this->encodeBuffer, sizeof(this->encodeBuffer));
	if (!pb_encode(&stream, MausOutgoingMessage_fields, msg)) {
		ESP_LOGE(tag, "failed to encode: %s", PB_GET_ERROR(&stream));
		return false;
	}

	ESP_LOGI(tag, "sending message of size %d", stream.bytes_written);

	xMessageBufferSend(buffer, this->encodeBuffer, stream.bytes_written, 0);
	return true;
};

NetController::Manager::Manager(NetController::Communicator interface) {
	this->comInterface = interface;
	ESP_LOGI(tag, "Manager()");

	xTaskCreate(receiverTask, "receiverTask", 2048, this, 5, NULL);
};

/**
 * @brief send a command to the BT SPP sender queue
 *
 * @param msg message to send
 * @return true msg was added to the sender queue
 * @return false queue not initialized
 */
template <typename T, int msgTag>
void NetController::Manager::writePacket(T packet) {
	MausOutgoingMessage msg = MausOutgoingMessage_init_zero;
	msg.which_payload = msgTag;
	*reinterpret_cast<T *>(&msg.payload) = packet;
	// ESP_LOGI(tag, "x %f y %f", msg.payload.nav.position.x, msg.payload.nav.position.y);

	writeCmd(&msg);
};
