xabirizar9/Micromaus-Challenge-TUM/src/net/OTA.cpp

#ifdef USE_OTA
#include "net/OTA.hpp"

#include <string.h>
#include <sys/socket.h>

#include "esp_event.h"
#include "esp_http_client.h"
#include "esp_https_ota.h"
#include "esp_log.h"
#include "esp_ota_ops.h"
#include "esp_system.h"
#include "freertos/FreeRTOS.h"
#include "freertos/task.h"
#include "nvs.h"
#include "nvs_flash.h"
#include "string.h"
#define HASH_LEN 32

#ifdef CONFIG_EXAMPLE_FIRMWARE_UPGRADE_BIND_IF
/* The interface name value can refer to if_desc in esp_netif_defaults.h */
#if CONFIG_EXAMPLE_FIRMWARE_UPGRADE_BIND_IF_ETH
static const char *bind_interface_name = "eth";
#elif CONFIG_EXAMPLE_FIRMWARE_UPGRADE_BIND_IF_STA
static const char *bind_interface_name = "sta";
#endif
#endif

static const char *TAG = "simple_ota_example";
extern const uint8_t server_cert_pem_start[] asm("_binary_ca_cert_pem_start");
extern const uint8_t server_cert_pem_end[] asm("_binary_ca_cert_pem_end");

#define OTA_URL_SIZE 256

esp_err_t _http_event_handler(esp_http_client_event_t *evt) {
	switch (evt->event_id) {
		case HTTP_EVENT_ERROR: ESP_LOGD(TAG, "HTTP_EVENT_ERROR"); break;
		case HTTP_EVENT_ON_CONNECTED: ESP_LOGD(TAG, "HTTP_EVENT_ON_CONNECTED"); break;
		case HTTP_EVENT_HEADER_SENT: ESP_LOGD(TAG, "HTTP_EVENT_HEADER_SENT"); break;
		case HTTP_EVENT_ON_HEADER:
			ESP_LOGD(
				TAG, "HTTP_EVENT_ON_HEADER, key=%s, value=%s", evt->header_key, evt->header_value);
			break;
		case HTTP_EVENT_ON_DATA: ESP_LOGD(TAG, "HTTP_EVENT_ON_DATA, len=%d", evt->data_len); break;
		case HTTP_EVENT_ON_FINISH: ESP_LOGD(TAG, "HTTP_EVENT_ON_FINISH"); break;
		case HTTP_EVENT_DISCONNECTED:
			ESP_LOGD(TAG, "HTTP_EVENT_DISCONNECTED");
			break;
			// case HTTP_EVENT_REDIRECT: ESP_LOGD(TAG, "HTTP_EVENT_REDIRECT"); break;
	}
	return ESP_OK;
}

void simple_ota_example_task(void *pvParameter) {
	ESP_LOGI(TAG, "Starting OTA example");
#ifdef CONFIG_EXAMPLE_FIRMWARE_UPGRADE_BIND_IF
	esp_netif_t *netif = get_example_netif_from_desc(bind_interface_name);
	if (netif == NULL) {
		ESP_LOGE(TAG, "Can't find netif from interface description");
		abort();
	}
	struct ifreq ifr;
	esp_netif_get_netif_impl_name(netif, ifr.ifr_name);
	ESP_LOGI(TAG, "Bind interface name is %s", ifr.ifr_name);
#endif
	esp_http_client_config_t config;
	config.url = "http://192.168.178.150:8070/hello_world.bin",
#ifdef CONFIG_EXAMPLE_USE_CERT_BUNDLE
	config.crt_bundle_attach = esp_crt_bundle_attach;
#else
	config.cert_pem = (char *)server_cert_pem_start;
#endif /* CONFIG_EXAMPLE_USE_CERT_BUNDLE */
	config.event_handler = _http_event_handler;
	config.keep_alive_enable = true;
#ifdef CONFIG_EXAMPLE_FIRMWARE_UPGRADE_BIND_IF
	config.if_name = &ifr;
#endif

#ifdef CONFIG_EXAMPLE_FIRMWARE_UPGRADE_URL_FROM_STDIN
	char url_buf[OTA_URL_SIZE];
	if (strcmp(config.url, "FROM_STDIN") == 0) {
		example_configure_stdin_stdout();
		fgets(url_buf, OTA_URL_SIZE, stdin);
		int len = strlen(url_buf);
		url_buf[len - 1] = '\0';
		config.url = url_buf;
	} else {
		ESP_LOGE(TAG, "Configuration mismatch: wrong firmware upgrade image url");
		abort();
	}
#endif

#ifdef CONFIG_EXAMPLE_SKIP_COMMON_NAME_CHECK
	config.skip_cert_common_name_check = true;
#endif

	esp_https_ota_config_t ota_config;
	ota_config.http_config = &config;
	ESP_LOGI(TAG, "Attempting to download update from %s", config.url);
	esp_err_t ret = esp_https_ota(ota_config.http_config);
	if (ret == ESP_OK) {
		esp_restart();
	} else {
		ESP_LOGE(TAG, "Firmware upgrade failed");
	}
	while (1) {
		vTaskDelay(1000 / portTICK_PERIOD_MS);
	}
}

static void print_sha256(const uint8_t *image_hash, const char *label) {
	char hash_print[HASH_LEN * 2 + 1];
	hash_print[HASH_LEN * 2] = 0;
	for (int i = 0; i < HASH_LEN; ++i) {
		sprintf(&hash_print[i * 2], "%02x", image_hash[i]);
	}
	ESP_LOGI(TAG, "%s %s", label, hash_print);
}

static void get_sha256_of_partitions(void) {
	uint8_t sha_256[HASH_LEN] = {0};
	esp_partition_t partition;

	// get sha256 digest for bootloader
	partition.address = ESP_BOOTLOADER_OFFSET;
	partition.size = ESP_PARTITION_TABLE_OFFSET;
	partition.type = ESP_PARTITION_TYPE_APP;
	esp_partition_get_sha256(&partition, sha_256);
	print_sha256(sha_256, "SHA-256 for bootloader: ");

	// get sha256 digest for running partition
	esp_partition_get_sha256(esp_ota_get_running_partition(), sha_256);
	print_sha256(sha_256, "SHA-256 for current firmware: ");
}

// expects wifi to already be connected
void setupOta() {
	// Initialize NVS.
	esp_err_t err = nvs_flash_init();
	if (err == ESP_ERR_NVS_NO_FREE_PAGES || err == ESP_ERR_NVS_NEW_VERSION_FOUND) {
		// 1.OTA app partition table has a smaller NVS partition size than the non-OTA
		// partition table. This size mismatch may cause NVS initialization to fail.
		// 2.NVS partition contains data in new format and cannot be recognized by this version of
		// code. If this happens, we erase NVS partition and initialize NVS again.
		ESP_ERROR_CHECK(nvs_flash_erase());
		err = nvs_flash_init();
	}
	ESP_ERROR_CHECK(err);

	get_sha256_of_partitions();

	xTaskCreate(&simple_ota_example_task, "ota_example_task", 8192, NULL, 5, NULL);
}

#endif
