xabirizar9/Micromaus-Challenge-TUM/(commit log)

2022-01-11 Upload New File
    [BestellungRS_2018_05_08-2.xls]
2022-01-12 added sharp distance sensor datasheet
2022-01-13 add pcb
    [esp32.sch]
2022-01-13 add green square
    [esp32.sch]
2022-01-13 added resistor
    [esp32.sch]
2022-01-13 added shit
    [esp32.sch]
2022-01-16 Added random stuff
    [2619S_SR_IE2-16.stp]
2022-01-16 updated libs & wip usb uart
    [esp32.sch]
2022-01-17 feat: add usb-uart schematics
    [2619S_SR_IE2-16.stp, esp32.sch, usb-uart.sch]
2022-01-17 added h-bridge schematic
    [h-bridge.sch]
2022-01-17 added schematic
    [IR_Sensor.sch]
2022-01-17 feat: connector in sensor diagram
    [maus.sch]
2022-01-17 chore: remove folder
    [IR_Sensor.sch, h-bridge.sch, maus.sch, usb-uart.sch]
2022-01-17 added enable cable
    [maus.sch]
2022-01-17 feat: add UART+power header
    [maus.sch]
2022-01-19 psu draft
    [power.sch]
2022-01-20 Revert "Sensor_akt"
    This reverts commit 3d197c96604575253fd7abde520af91cfe0fb7dc, reversing
    changes made to 6c7812dcfceef42d4864bf92aec908c2e8f5b5d9.
    [maus.sch]
2022-01-20 restored power.sch
    [power.sch]
2022-01-20 moved to main project
    [power.sch]
2022-01-20 improved power supply
    [power.sch]
2022-01-20 added xt60 connector
2022-01-20 added xt60 input to power supply
    [power.sch]
2022-01-20 added IMU chip datasheet
2022-01-20 Schematic der GYros
    [Gyro.sch]
2022-01-21 feat: add motor sheet
2022-01-21 Connected hbridge to motor connectors
    [maus.sch]
2022-01-23 update motor encoders
    [maus.sch]
2022-01-23 feat: merge power
    [maus.sch]
2022-01-23 restored 3.3v regulator library
2022-01-23 fixed MP233H pin directions
2022-01-23 fixed XT60 pin directions
2022-01-23 refreshed symbols in power.sch (fixes ERC errors)
    [power.sch]
2022-01-23 feat: wire esp32
    [maus.sch]
2022-01-23 feat: update pcb
    [maus.sch]
2022-01-24 feat: cleanup H-Bridge + add debug leds and pins
    [maus.sch]
2022-01-25 fix: removed micromaus dir
    [maus.sch, power.sch]
2022-01-25 Moved position of capacitors
    [maus.sch]
2022-01-25 Added 3.3V connection
    [maus.sch]
2022-01-25 Exported part list as csv
    [part_list.csv]
2022-01-25 Changed capacitor
    [maus.sch]
2022-01-25 Added BOM
    [BOM.csv]
2022-01-25 Removed unnecessary csv
    [part_list.csv]
2022-01-25 Changed transistor type
    [maus.sch]
2022-01-25 fix: added pullups on EN and IO0
    [maus.sch]
2022-01-25 swapped BC847 -> BSS123 in power schematics
    [maus.sch]
2022-01-26 added reference schematics for use of ch340c
2022-01-27 pinheader forleftover pins, new sensor naming
    [maus.sch]
2022-01-27 added Pmos symbol/footprint
2022-01-27 replaced pmos fets in schematic with the new one
    [maus.sch]
2022-01-27 added driver for sensor power mosfet
    [maus.sch]
2022-01-27 fixed mosfet part prefix
    [maus.sch]
2022-01-27 removed note about mosfet in power schematic. close #14
    [maus.sch]
2022-01-27 now uses LM358DR opamp
    [maus.sch]
2022-01-27 fix: self powered CP2102 & CH340C, enable pin voltages ES32
    [maus.sch]
2022-01-28 set led resistors to 1k, fixes #10
    [maus.sch]
2022-01-28 added a SPI breakout
    [maus.sch]
2022-01-28 set led 1206 package , R/C 0805. close #8
    [maus.sch]
2022-01-28 feat: add mouser USB-B
    [maus.sch]
2022-01-28 fix: remove extra caps from 3v3 esp32
    [maus.sch]
2022-01-28 added esp32-s2 chip datasheet
2022-01-28 Revert "fix: remove extra caps from 3v3 esp32"
    This reverts commit 98a652b0698d76106b42ebf40b6ec01f9ce7920d.
    [maus.sch]
2022-01-28 moved modor 2 pins and added pullup to io18
    [maus.sch]
2022-01-28 fixup! added a SPI breakout
    [maus.sch]
2022-01-28 fixed mosfet 3d models, added other mosfet
2022-01-28 now use new mosfet
    [maus.sch]
2022-01-29 fixed some ERC errors
    [maus.sch]
2022-01-30 maus board layout
    [maus.sch]
2022-01-31 fixed ICM-20948 module pin drill size
    [maus.brd, maus.sch]
2022-01-31 ordered components for routing Buck
    [maus.brd]
2022-01-31 SPI is now a bus... thought that might allow for better guided routing
    [maus.brd, maus.sch]
2022-01-31 renamed USB signals so that they can be routed as a differential pair
    [maus.brd, maus.sch]
2022-01-31 added 'power' netclass
    [maus.brd, maus.sch]
2022-01-31 add: lib MBRS360
    [maus.brd, maus.sch]
2022-01-31 Added diodes for hbridge
    [maus.brd, maus.sch]
2022-01-31 Attached ENABLE pins to PWM
    [maus.brd, maus.sch]
2022-02-01 M. und S. Halterungen footprints
2022-02-01 removed old buck datasheet, added new
2022-02-01 Halterungen in brd hinzugefügt
    [maus.brd]
2022-02-01 Changed diodes
    [maus.brd, maus.sch]
2022-02-01 replaced buck converter
    [maus.brd, maus.sch]
2022-02-01 set minimum trach widths
    [maus.brd, maus.sch]
2022-02-01 routed buck
    [maus.brd, maus.sch]
2022-02-01 routed most power circuitry
    [maus.brd, maus.sch]
2022-02-03 routed USB
    [maus.brd, maus.sch]
2022-02-05 Positioned diodes for routing and moved motor connector
    [maus.brd, maus.sch]
2022-02-05 Routed M+- to motor connector
    [maus.brd]
2022-02-06 fixed motor power track width settings
    [maus.brd, maus.sch]
2022-02-07 Sensoren wired
    [maus.brd]
2022-02-07 feat: add leds + cap esp32
    [maus.brd]
2022-02-07 feat: move leds
    [maus.brd, maus.sch]
2022-02-07 locked key elements
    [maus.brd]
2022-02-07 Revert "locked key elements"
    This reverts commit a2a147baeef38ebe17c057637a63e03ba7b3c23b.
    [maus.brd]
2022-02-07 place vsense
    [maus.brd]
2022-02-07 pcb update
    [maus.brd, maus.sch]
2022-02-07 Fuck my life
    [maus.brd]
2022-02-07 fuck my life 2.0
    [maus_backup.brd]
2022-02-07 gold master
    [maus.brd]
2022-02-08 update board
    [maus.brd, maus.sch]
2022-02-08 add qr code
    [maus.brd]
2022-02-08 replace old libraries
    [maus.brd, maus.sch]
2022-02-08 replace motor and sensor footprints
    [maus.brd]
2022-02-08 fixed some autorouter shit
    [maus.brd]
2022-02-08 set power tracks to (hopefully) sensible width
    [maus.brd]
2022-02-08 set motor track size 30mil (for ca. 700mA)
    [maus.brd]
2022-02-08 Changed via sizes
    [maus.brd]
2022-02-09 update vias and fix DRC issues
    [maus.brd, maus.sch]
2022-02-09 removed some long tracks on gnd plane
    [maus.brd]
2022-02-09 removed wire stubs
    [maus.brd]
2022-02-09 via am C27
    [maus.brd]
2022-02-11 meeting mit alex
    [maus.brd]
2022-02-11 feat: update hbridge, connectors and add motor overlap
    [maus.brd, maus.sch]
2022-02-11 Connected GPIO and moved around some cablesÇ
    [maus.brd]
2022-02-12 Routed more parts. Small problem with left/front/right sensors
    [maus.brd, maus.sch]
2022-02-13 Revert "Routed more parts. Small problem with left/front/right sensors"
    This reverts commit 632d98e9f85293ddea98e20d506f01e9db345fa7.
    [maus.brd, maus.sch]
2022-02-13 update sensor + btn wiring
    [maus.brd, maus.sch]
2022-02-13 update JP5 wiring
    [maus.brd]
2022-02-13 motor battery power 80mil
    [maus.brd]
2022-02-13 added a fat bridge for ground
    [maus.brd]
2022-02-13 added a nice looking polygon for transistor
    [maus.brd]
2022-02-13 improved gpio connector pin order
    [maus.brd, maus.sch]
2022-02-13 optimized silkscreen
    [maus.brd]
2022-02-13 unified via sizes
    [maus.brd]
2022-02-13 power supply width fix; drc fixes
    [maus.brd]
2022-02-13 one more aesthetic fix
    [maus.brd]
2022-02-13 fixup! power supply width fix; drc fixes
    [maus.brd]
2022-02-13 fix: L1 crash XT60
    [maus.brd]
2022-02-13 fix: is now a square
    [maus.brd]
2022-02-13 minor fixes
    [maus.brd]
2022-02-15 BOM with mouser links
    [BOM.csv]
2022-02-15 fix: akku hatte falsche spannung
    [BOM.csv]
2022-02-17 added merged BOM
    [bestellliste_merge.xlsx]
2022-02-17 changed prox sensor for team minimouse
    [bestellliste_merge.xlsx]
2022-02-17 merged Mendoza's partlist
    [bestellliste_merge.xlsx]
2022-02-17 added distance sensors to mendoza bom
    [bestellliste_merge.xlsx]
2022-02-17 diese version der bestellliste an alex versendet
    [bestellliste_merge.xlsx]
2022-03-06 filter algo theorie
2022-03-06 added gitlab ci for filter algo pdf
2022-03-08 added initial Encoder interface code
2022-03-08 (untested) Encoder now uses dynamic allocation of pulseCounter
2022-03-09 fixup! (untested) Encoder now uses dynamic allocation of pulseCounter
    classical fixes
    [Encoder.cpp]
2022-03-14 fix: resolve serial encoding issue
    [SerialBluetooth.cpp, SerialBluetooth.hpp, main.cpp]
2022-03-15 feat: add full stream chain
2022-03-15 feat: switch to Wifi...
2022-03-15 set sensible io numbers for encoder
2022-03-15 feat: refactor udp sockets
2022-03-16 added support library for ADC
2022-03-16 fixup! Merge branch 'feature/adc-singleton'
    [ADC.cpp]
2022-03-17 feat: add golang UDP socket handler
2022-03-17 added calibration measurements spreadsheet
    [voltage_measurements.ods]
2022-03-17 added a config.h for pin numbers
2022-03-17 needed to get over adc code from Sensors_tests
2022-03-17 deleted ADC2 which can't be used, adc reading now reports millivolts
2022-03-17 optimization: we need no reference to the adc
2022-03-18 renamed voltage_measurements.ods -> versuchsreihen.ods
    [versuchsreihen.ods]
2022-03-18 fix: buffer issues in UDP streamer
    [ADC.cpp, NetController.cpp, WifiCommunicator.cpp, config.h, main.cpp]
2022-03-18 added some fits for the ir sensor measurements
    [versuchsreihen.ods]
2022-03-18 added power::VoltageGauge and power::Battery classes
2022-03-18 now uses correct millivolt readings
    [Power.cpp, Power.hpp]
2022-03-18 PowerManagement class / thread
2022-03-18 adds PowerManagement to main task
2022-03-18 can now establish i2c connection to module
2022-03-18 SPI classes
2022-03-18 some more i2c ICM things
2022-03-18 more spi things
2022-03-18 added 16 bit SPI r/w functions
2022-03-18 (wip) added IMU init functions
2022-03-18 save current register bank so we don't repeatedly switch to the same bank
2022-03-18 fixed SPI comms
2022-03-18 fixup! (untested) added acceleration reading
    [ICM20948.cpp]
2022-03-18 added missing things, mist
    [icm_registers.hpp]
2022-03-18 added buffer reading capablilites to SPI
2022-03-18 added temperature reading in celsius
2022-03-18 added accelerometer reading in physical units (of G)
2022-03-18 added ICM20948 Gyro range setting and reading in physical units (deg per sec)
2022-03-18 (wip) magnetometer startup
2022-03-18 can now setup the magnetometer, reading it still doesn't work
    [ICM20948.cpp, ICM20948.hpp]
2022-03-18 fix: i2c master reads data (instead of writing)
    [ICM20948.cpp]
2022-03-18 fix: magnetometer endianness
2022-03-18 made SPI compatible with S2
2022-03-18 gpio numbers for SPI
2022-03-19 added LEDCChannelResource shared resource
2022-03-19 added Motor class
2022-03-20 feat: add basic PID controller
2022-03-22 correct PID controller
2022-03-22 wip: PID
2022-03-22 feat: add initial PID setup
2022-03-23 fix: revert changes to controller
    [Controller.cpp]
2022-03-24 modell für ir-sensor
2022-03-25 feat: update PID & add ping-pong
2022-03-25 added clamp function and linecontrol PID
2022-03-25 added schematic as appendix
2022-03-25 camel case
2022-03-26 more text about hardware, sensors, h-bridge, power supply, low-power mode
2022-03-28 wip: auto PID tunner
2022-03-29 wip: add steering
2022-03-29 feat: add driver
2022-03-29 feat: add remote connector interface
2022-04-03 feat: switch to relative dead reconning
2022-04-03 "movecell with encoder"
2022-04-05 added script scripts/check-staged-format.sh to check for changes that introduce formatting errors, useful as a pre-commit hook
2022-04-05 fix: check-staged-format does not ignore new files
    fix: check-staged-format works even if no c/hpp files added
2022-04-05 (wip) a little bit of structure for the filter
2022-04-05 feat: add update sensors
2022-04-05 feat: update PID
2022-04-06 feat: add variable correction
    [DriveTask.cpp]
2022-04-06 added pin() method to set standard deviations to zero
2022-04-07 compute velocity profile for straight lines
2022-04-11 wip: lane + PID improvements
2022-04-12 added fixes for motion profiles
    [DriveTask.cpp, MotionProfile.cpp, MotionProfile.hpp]
2022-04-12 feat: tune pid
2022-04-15 fixed things for motion profile
    [DriveTask.cpp, MotionProfile.cpp, MotionProfile.hpp]
2022-04-16 fix: cmd memory issue
    [DriveTask.cpp, LanePID.cpp, MotionProfile.hpp]
2022-04-16 finished switch cases and fixed turnonspot
    [DriveTask.cpp, MotionProfile.cpp, MotionProfile.hpp]
2022-04-17 fix: adapted distance driven in grid profiles to avoid overshooting
    [MotionProfile.hpp]
2022-04-17 fix: grid cell computation
    [DriveTask.cpp, MotionProfile.cpp, MotionProfile.hpp]
2022-04-26 ADC: universally compilable bit width
2022-04-28 changed wheel distance
2022-04-28 fix: added correction at end of moveCells
    [DriveTask.cpp]
2022-04-28 pid refactor + use pid instead of motion profile for MoveCells
2022-04-28 tuned MoveCells PID value
2022-04-28 fix: time interval counters
    [DriveTask.cpp]
